JAndrassy/SunriseClock/README.md

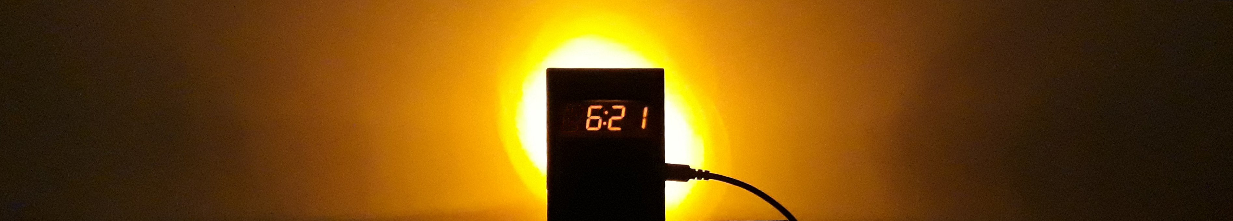
[picture p1: img/sunriseclock-wide.jpg]


# SunriseClock

A light 'alarm' clock designed for gentle wake-up with increasing light intensity. Uses Wemos D1 mini, encoder with button, clock display with TM1637, LDR and 10 LEDs controlled as 4+3+3 blocks over 3 transistors. Everything soldered on a perfboard and put in a box.

* The esp8266 connects once a day to Internet to get time from NTP server
* To set WiFi parameters and advanced configuration [WiFiManager library](https://github.com/tzapu/WiFiManager#how-it-works) in SoftAP mode is used
* LDR is used to adjust clock display brightness according to ambient light
* Other alarm options are cycling LEDs, pulsing LEDs, full brightness of clock display, blinking clock display
* alarm on weekend is optional and has a separate alarm time setting
* if you like fall asleep with light, fade, fireplace and candles light effects are available
* the LEDs can be turned on and the intensity can be set by rotating the encoder
* the dim lighting and the fireplace or candles effect are nice not only for sleep :-)

## Images

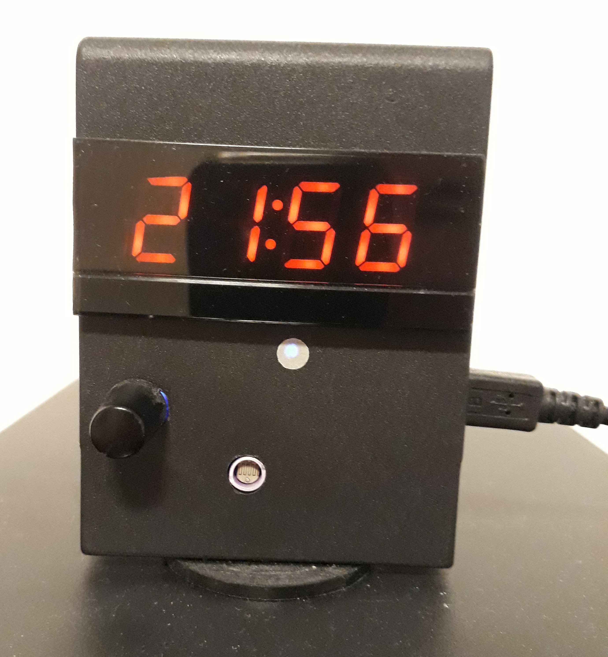
[picture p2: img/sunriseclock-front.jpg]
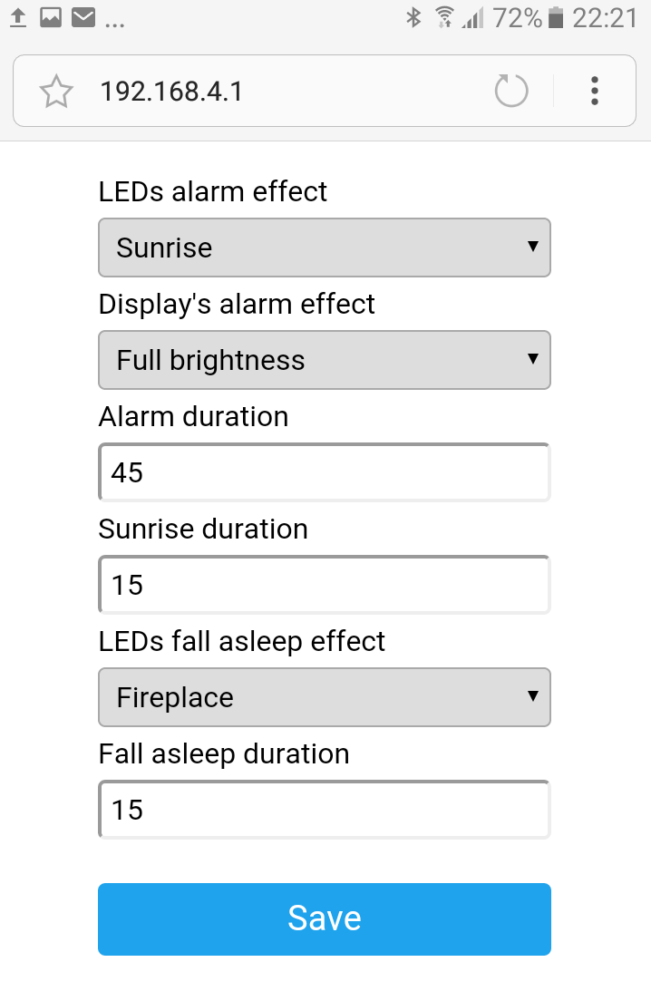
[picture p3: img/sunriseclock-setup.png]
 
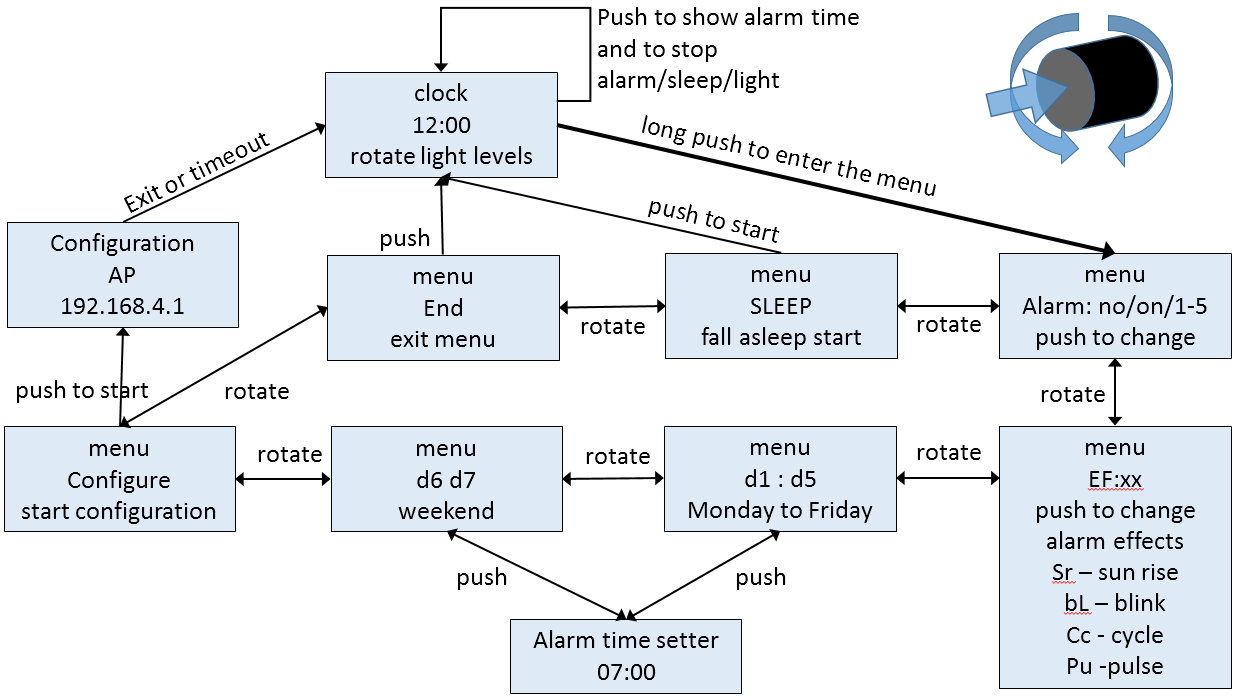
[picture p4: img/sunriseclock-manual.png]

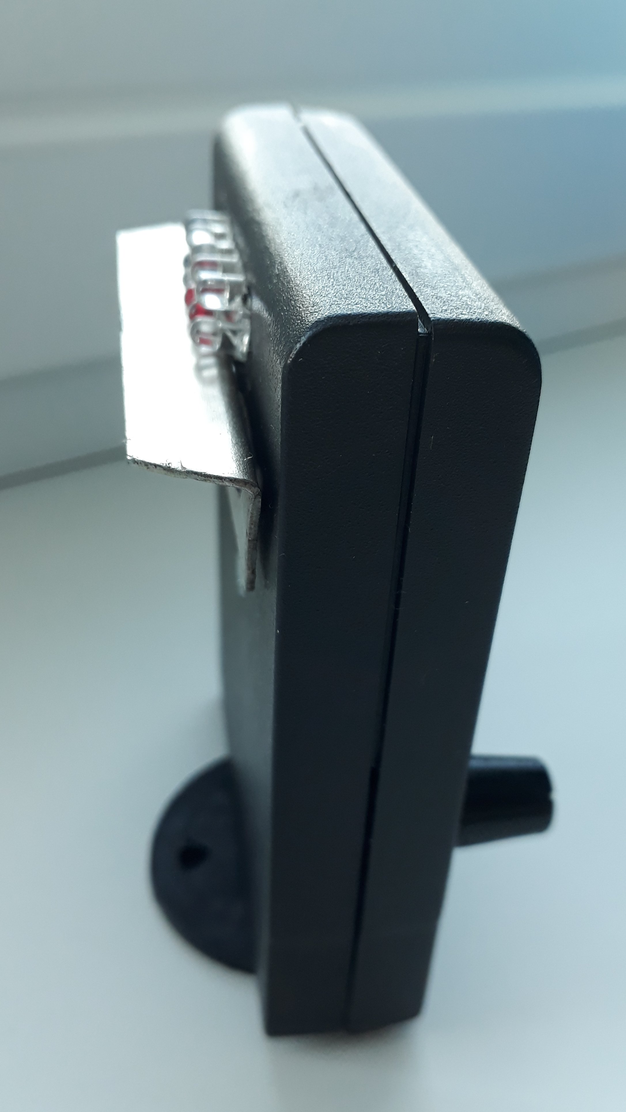
[picture p5: img/sunriseclock-back.jpg]
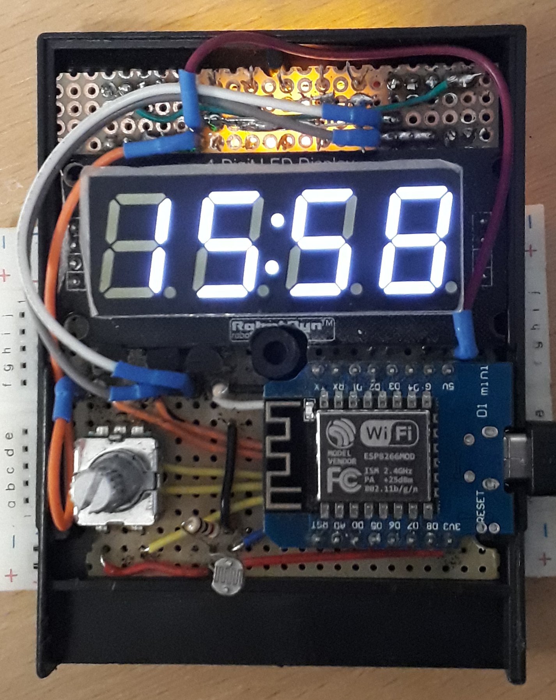
[picture p6: img/sunriseclock-open.jpg]
 

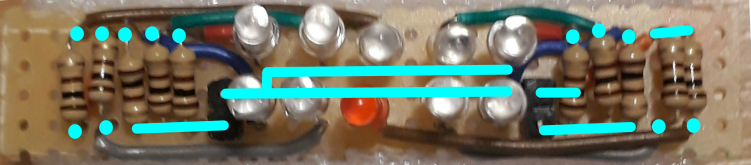
[picture p7: img/sunriseclock-perfboard-leds-front.png]
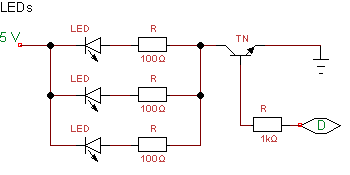
[picture p8: img/LEDsNPN.png]

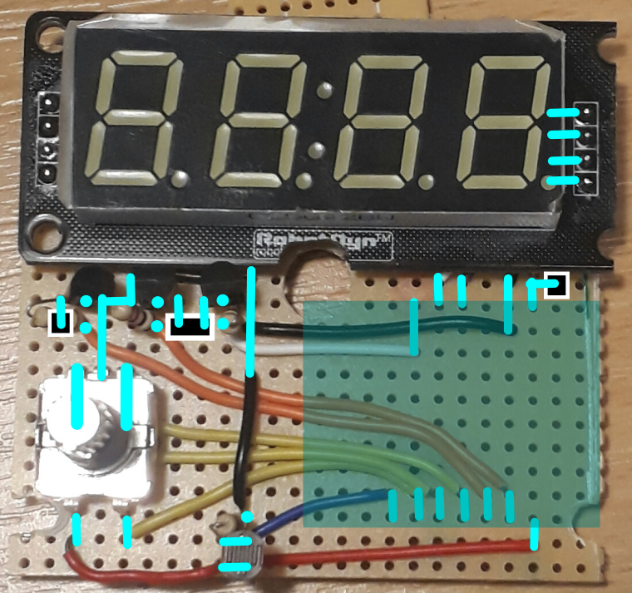
[picture p9: img/sunriseclock-perfboard-front.png]


## Some notes

* I create pictures with marks what to solder because I let the soldering to a skilled buddy
* if I would make the board again, I would put the encoder and the LDR higher and position the transistors at bottom
* the jumper wires are 10cm 'dupont' jumper wires with the black plastic replaced with heat shrink tube and then bent at the flat part of the connector
* the Wemos D1 has the CH340 on bottom side. it doesn't collide with the wires because the D1 is raised a little 
* the central LEDs are 3 yellow and one red. left and right block use 3 yellow LEDs each
* the LEDs are soldered only on the power 'rail', the other leg is only tight in the hole with the wire. this allows to aim the LEDs
* the fireplace effect has center LEDs slowly random pulsing in smaller PWM range and the left and right LEDs fast random pulsing at full PWM range. the 'fire' fades over falling asleep time.
* the candles effect uses slow random pulsing of left and right LEDs block at small PWM range
* and yes, I will buy a cable with 90° micro USB connector

## 3d print model

My original case was an off-the-shelf box. Now I 3d printed an upgraded version. And I added an USB connector for the back side (power only). 

* [back part on TnkerCAD](https://www.tinkercad.com/things/0kZU8gUUcHl-sunrise-clock-back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)
* [front part on TnkerCAD](https://www.tinkercad.com/things/csi3a3ySyaI-sunrise-clock-front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)

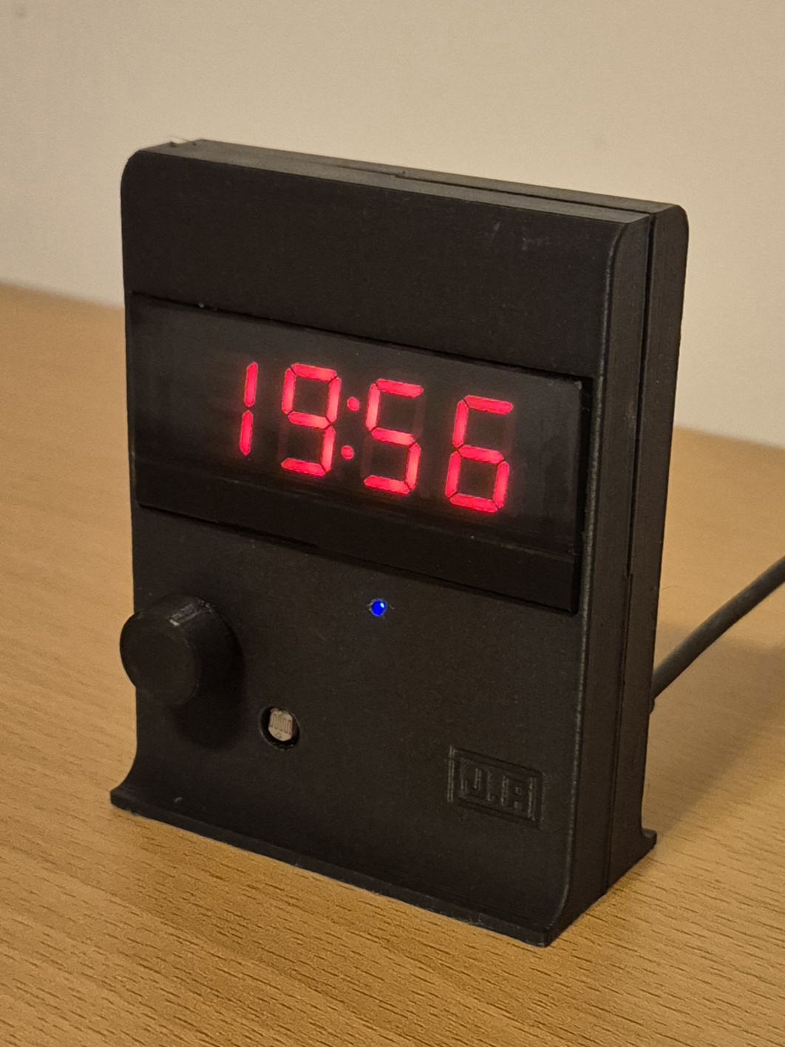
[picture p10: img/sunriseclock-front-3d-printed.jpg]
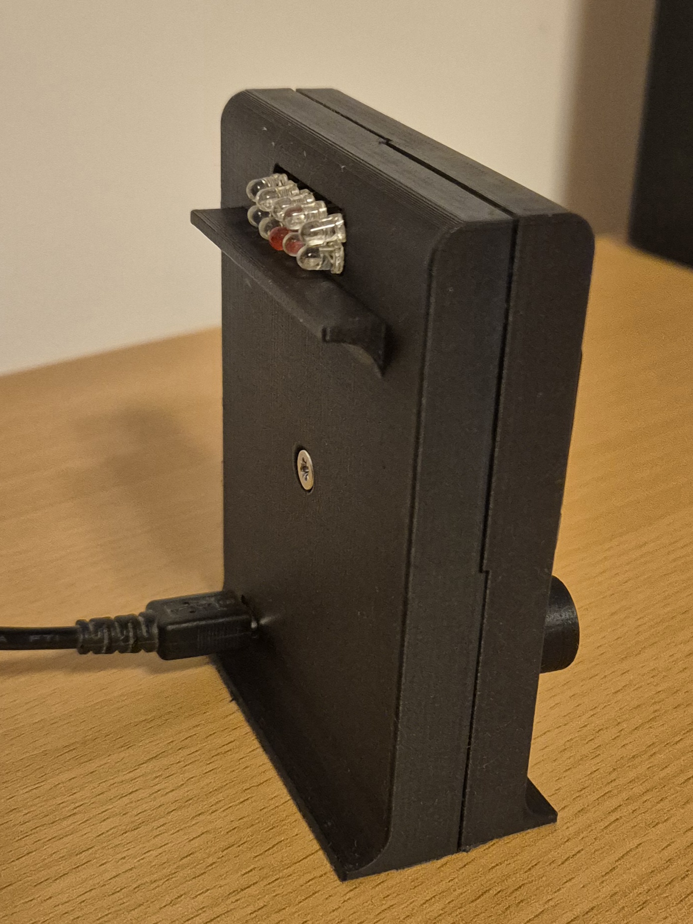
[picture p11: img/sunriseclock-back-3d-printed.jpg]
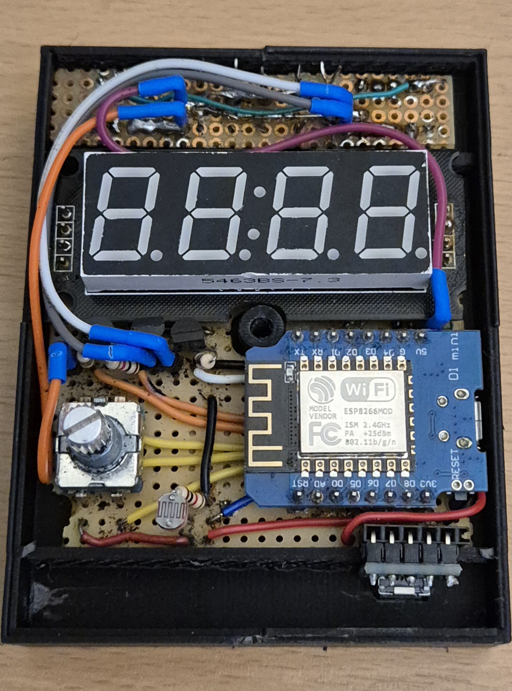
[picture p12: img/sunriseclock-open-2.jpg]
