JAndrassy/SunriseClock/img/sunriseclock-light.jpg

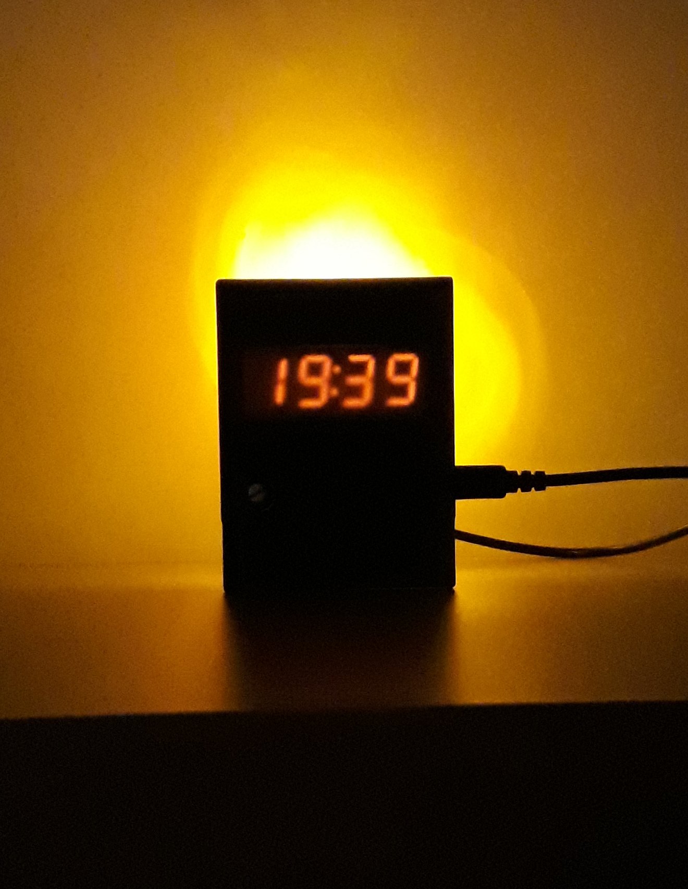
img/sunriseclock-light.jpg
