JAndrassy/SunriseClock/(threads)

Thread 3 (2025-07-21):

Adding menu parameters to WifiManager

carl1961, 2025-07-21:
great Sunrise clock (currently building)  I wishing to understand how you Adding menu parameters to WifiManager and how the code gets the settings from the custom WifiManagers Portal. I studied your code and see , but hard for me to separate the Wifimanager code from theTM1637 menu code. I like how you did this. I am wanting to do the same for a Astronomical Clock, so when I donate it to a school, they do not have to have Arduino ide to have to change settings, Longitude, Latitude, and Wi-Fi access.

carl1961, 2025-07-21:
Thanks! I knew it was different than anything I saw, Nice

Closed 2025-07-22.
