JAndrassy/SunriseClock/(commit log)

2022-07-02 in setup() retry joining WiFi after 2 minutes of conf. AP
    because after power outage the router needs time to boot
2024-08-31 esp8266 Arduino 3; latest lib versions; compilation warnings handled
2026-07-11 README - 3d printed case
